Torstein-Eide/DS412-BP-SATA-Hardware/kicad/DS412-BP-SATA.kicad_sch

## KiCad design kicad/DS412-BP-SATA.kicad_sch (2026-10-23)

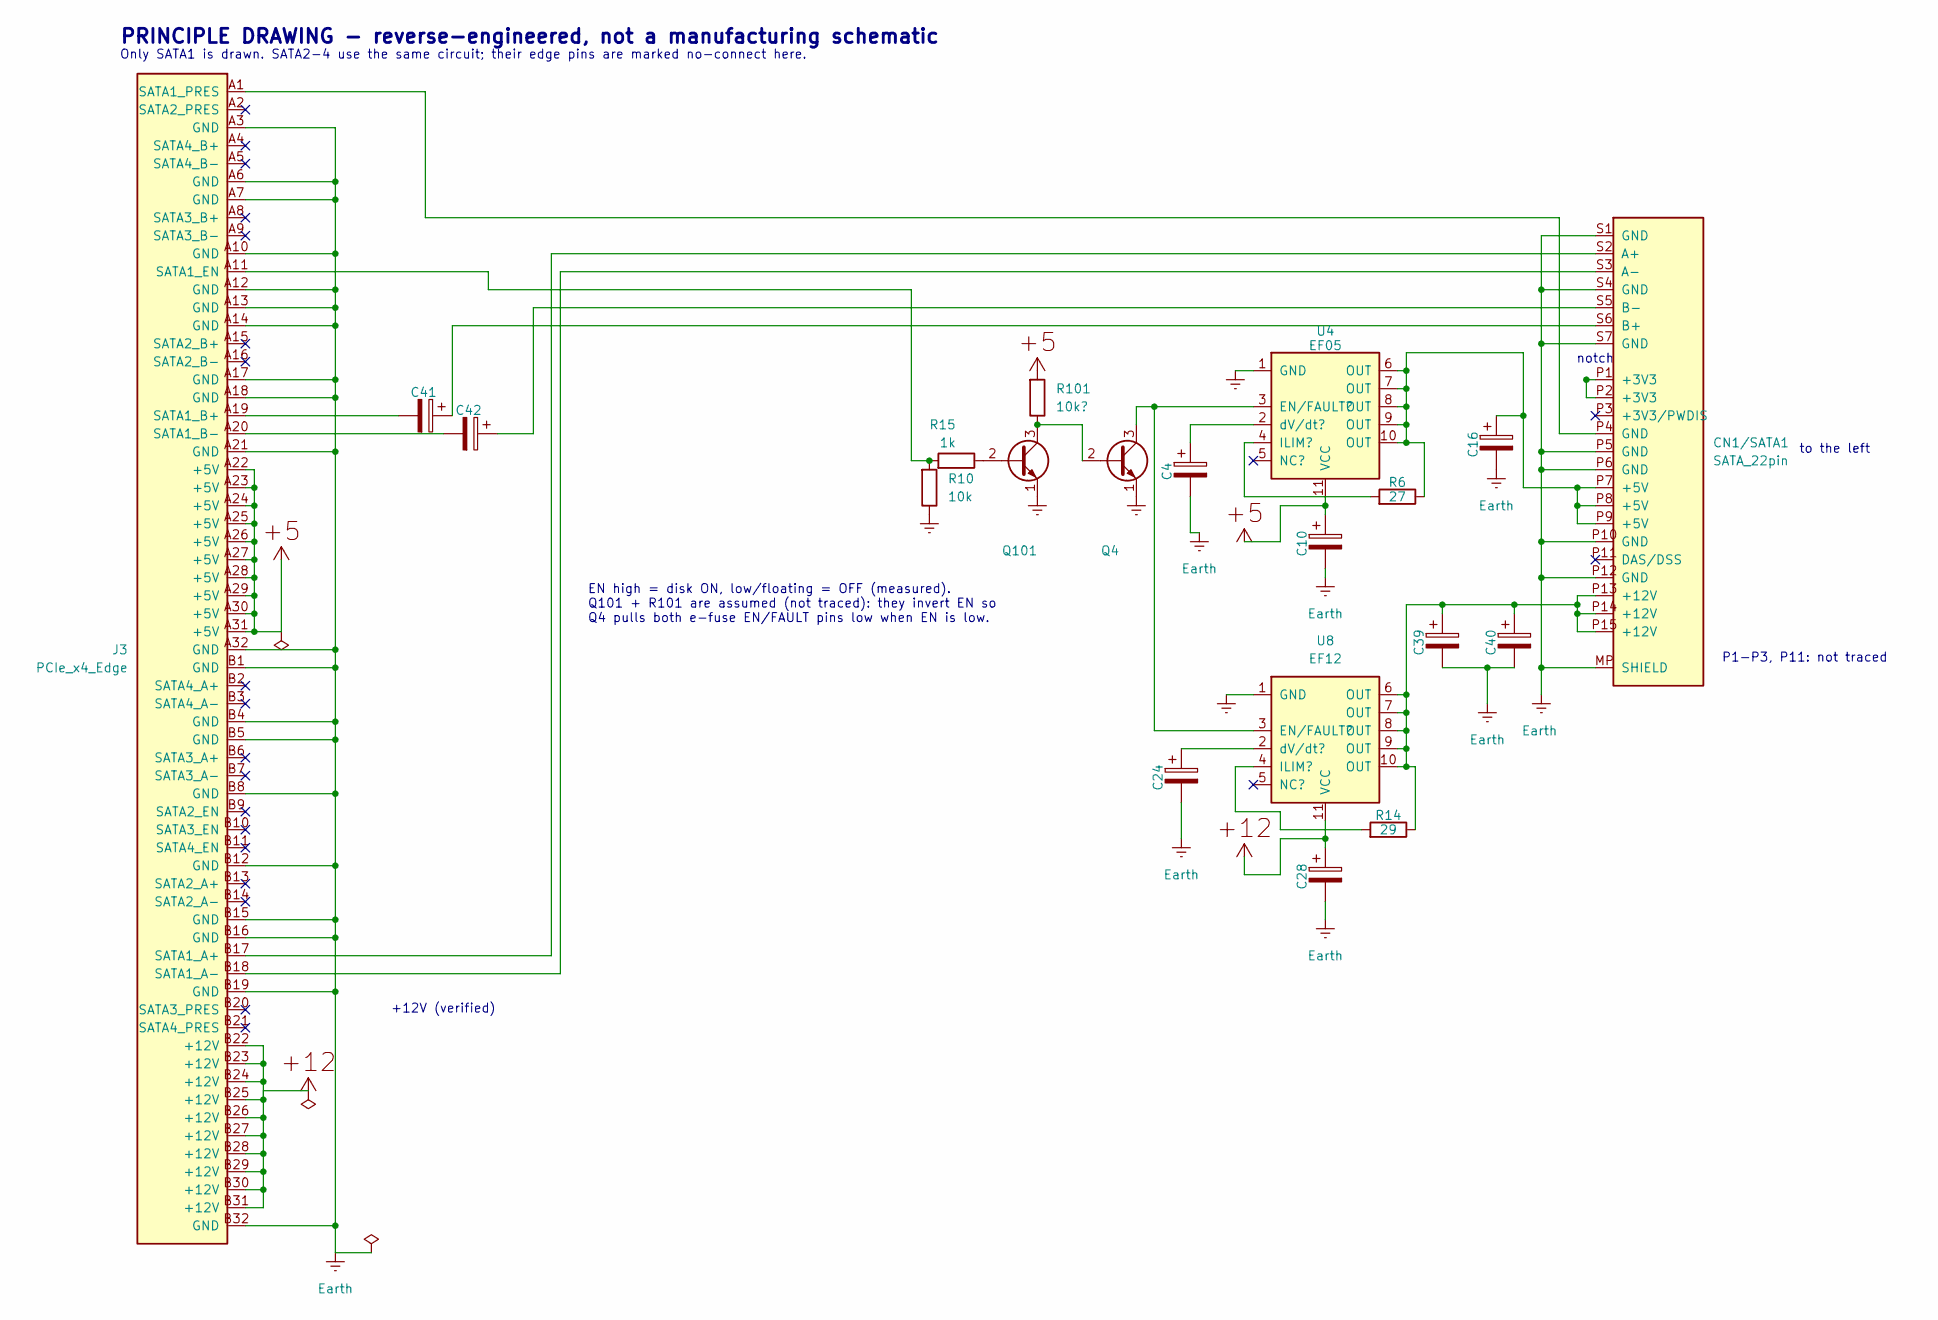
[picture p1: schematic DS412-BP-SATA.kicad_sch]

Parts:
C4, C10, C16, C24, C28, C39, C40, C41, C42: CP_Axial_L10.0mm_D4.5mm_P15.00mm_Horizontal
CN1/SATA1: SATA_22pin; SATA_Amphenol_10029364-001LF_Horizontal
J3: PCIe_x4_Edge; BUS_PCIexpress_x4
Q4: TO-18-3
Q101: NPN (assumed); TO-18-3
R6: 27; R_0201_0603Metric
R10: 10k; R_0201_0603Metric
R14: 29; R_0201_0603Metric
R15: 1k; R_0201_0603Metric
R101: 10k?; R_0201_0603Metric
U4: EF05; MSOP-10-1EP_3x3mm_P0.5mm_EP1.68x1.88mm
U8: EF12; MSOP-10-1EP_3x3mm_P0.5mm_EP1.68x1.88mm

Connections:
Earth: C4.2, C10.2, C16.2, C24.2, C28.2, C39.2, C40.2, CN1/SATA1.MP (SHIELD), CN1/SATA1.P5 (GND), CN1/SATA1.P6 (GND), CN1/SATA1.P10 (GND), CN1/SATA1.P12 (GND), CN1/SATA1.S1 (GND), CN1/SATA1.S4 (GND), CN1/SATA1.S7 (GND), J3.A3 (GND), J3.A6 (GND), J3.A7 (GND), J3.A10 (GND), J3.A12 (GND), J3.A13 (GND), J3.A14 (GND), J3.A17 (GND), J3.A18 (GND), J3.A21 (GND), J3.A32 (GND), J3.B1 (GND), J3.B4 (GND), J3.B5 (GND), J3.B8 (GND), J3.B12 (GND), J3.B15 (GND), J3.B16 (GND), J3.B19 (GND), J3.B32 (GND), Q4.1 (E), Q101.1 (E), R10.2, U4.1 (GND), U8.1 (GND)
unnamed: C4.1, U4.2 (dV/dt?)
unnamed: C16.1, CN1/SATA1.P7 (+5V), CN1/SATA1.P8 (+5V), CN1/SATA1.P9 (+5V), R6.2, U4.6 (OUT), U4.7 (OUT), U4.8 (OUT), U4.9 (OUT), U4.10 (OUT)
unnamed: C24.1, U8.2 (dV/dt?)
unnamed: C39.1, C40.1, CN1/SATA1.P13 (+12V), CN1/SATA1.P14 (+12V), CN1/SATA1.P15 (+12V), R14.2, U8.6 (OUT), U8.7 (OUT), U8.8 (OUT), U8.9 (OUT), U8.10 (OUT)
unnamed: C41.1, CN1/SATA1.S6 (B+)
unnamed: C41.2, J3.A19 (SATA1_B+)
unnamed: C42.1, CN1/SATA1.S5 (B-)
unnamed: C42.2, J3.A20 (SATA1_B-)
unnamed: CN1/SATA1.P1 (+3V3), CN1/SATA1.P2 (+3V3)
unnamed: CN1/SATA1.P4 (GND), J3.A1 (SATA1_PRES)
unnamed: CN1/SATA1.S2 (A+), J3.B17 (SATA1_A+)
unnamed: CN1/SATA1.S3 (A-), J3.B18 (SATA1_A-)
unnamed: J3.A11 (SATA1_EN), R10.1, R15.1
unnamed: Q4.3 (C), U4.3 (EN/FAULT?), U8.3 (EN/FAULT?)
unnamed: Q101.2 (B), R15.2
unnamed: Q4.2 (B), Q101.3 (C), R101.2
unnamed: R6.1, U4.4 (ILIM?)
unnamed: R14.1, U8.4 (ILIM?)
P,+5: C10.1, J3.A22 (+5V), J3.A23 (+5V), J3.A24 (+5V), J3.A25 (+5V), J3.A26 (+5V), J3.A27 (+5V), J3.A28 (+5V), J3.A29 (+5V), J3.A30 (+5V), J3.A31 (+5V), R101.1, U4.11 (VCC)
P,+12: C28.1, J3.B22 (+12V), J3.B23 (+12V), J3.B24 (+12V), J3.B25 (+12V), J3.B26 (+12V), J3.B27 (+12V), J3.B28 (+12V), J3.B29 (+12V), J3.B30 (+12V), J3.B31 (+12V), U8.11 (VCC)

Notes on the sheet:
to the left
notch
+12V (verified)
PRINCIPLE DRAWING - reverse-engineered, not a manufacturing schematic
Only SATA1 is drawn. SATA2-4 use the same circuit; their edge pins are marked no-connect here.
EN high = disk ON, low/floating = OFF (measured). Q101 + R101 are assumed (not traced): they invert EN so Q4 pulls both e-fuse EN/FAULT pins low when EN is low.
P1-P3, P11: not traced
